borstlab/super_bowl_screen/README.md

# super_bowl_screen

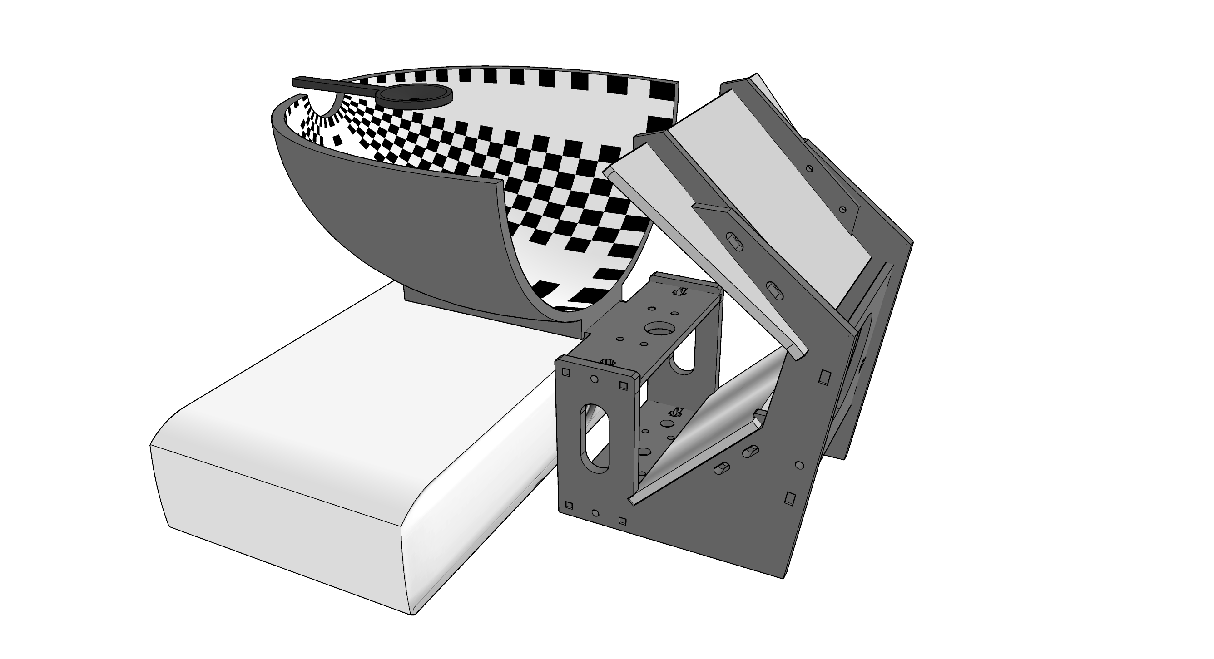
[picture p1: Bowl_Arena side.png]
bowl_arena
