borstlab/super_bowl_screen/CAD/CAD/_.jpg

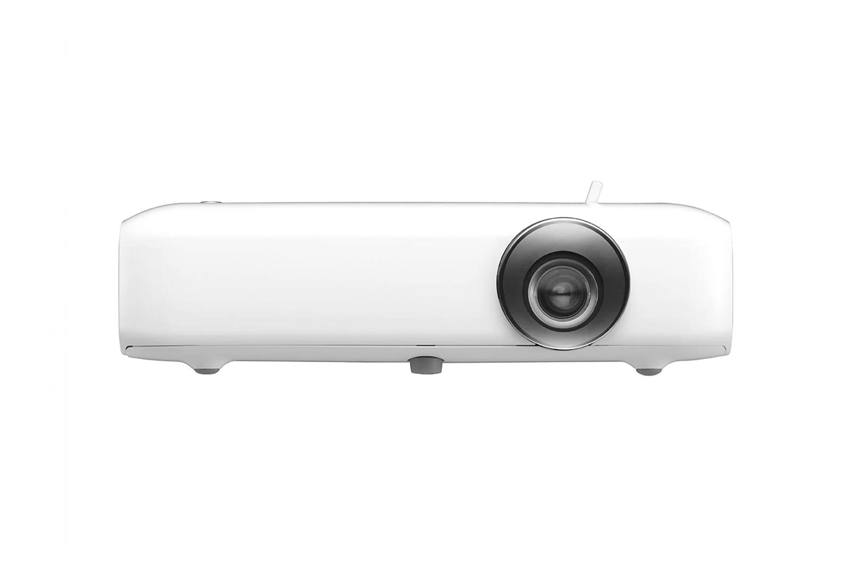
CAD/CAD/_.jpg
