borstlab/super_bowl_screen/CAD/render from inside the bowl.jpg

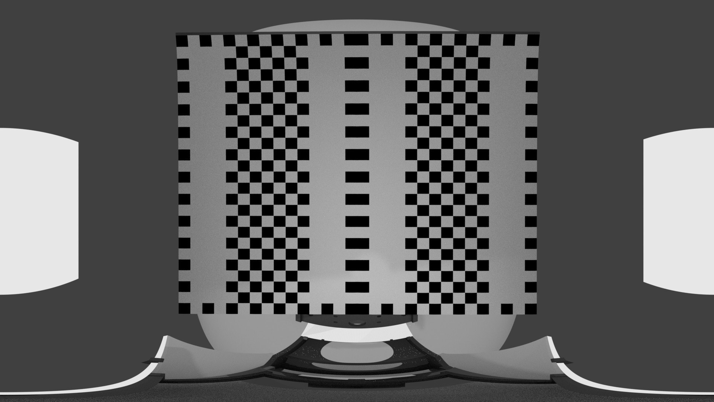
CAD/render from inside the bowl.jpg
