borstlab/super_bowl_screen/Figures/Code/Fig 2/Bleeding13.PNG

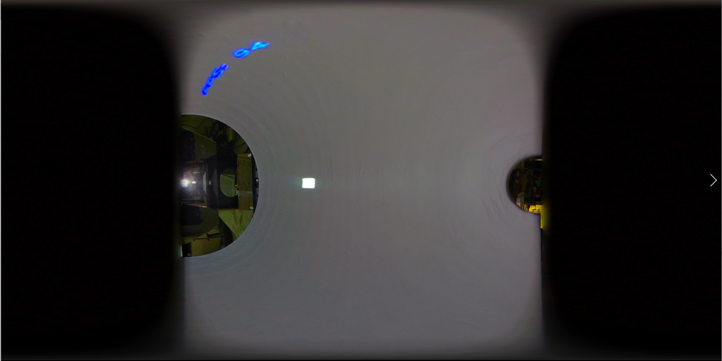
Figures/Code/Fig 2/Bleeding13.PNG
