borstlab/super_bowl_screen/Figures/Code/Fig 2/Bleeding18.PNG

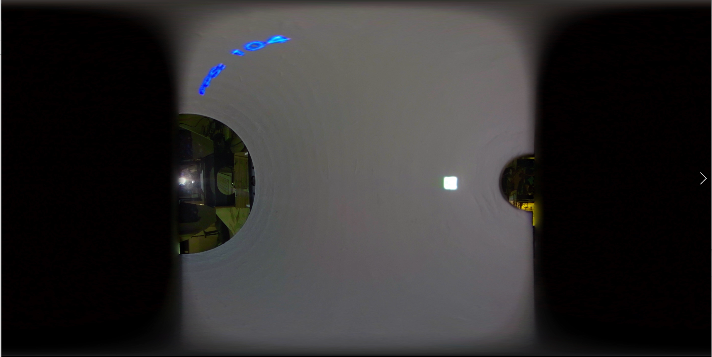
Figures/Code/Fig 2/Bleeding18.PNG
