borstlab/super_bowl_screen/CAD/3d Print V1.1/Bowl_LG_VS2_bowl_holder.stl

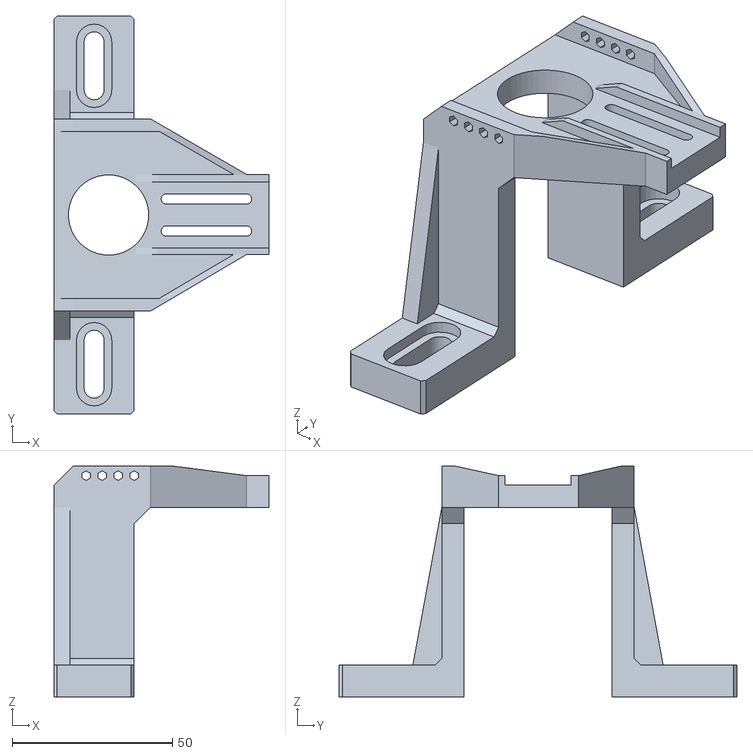
[picture p7: CAD file, 2024-04-22]
CAD/3d Print V1.1/Bowl_LG_VS2_bowl_holder.stl
67.0 x 124.0 x 72.0
