borstlab/super_bowl_screen/CAD/Arena Shape 3D print.stl

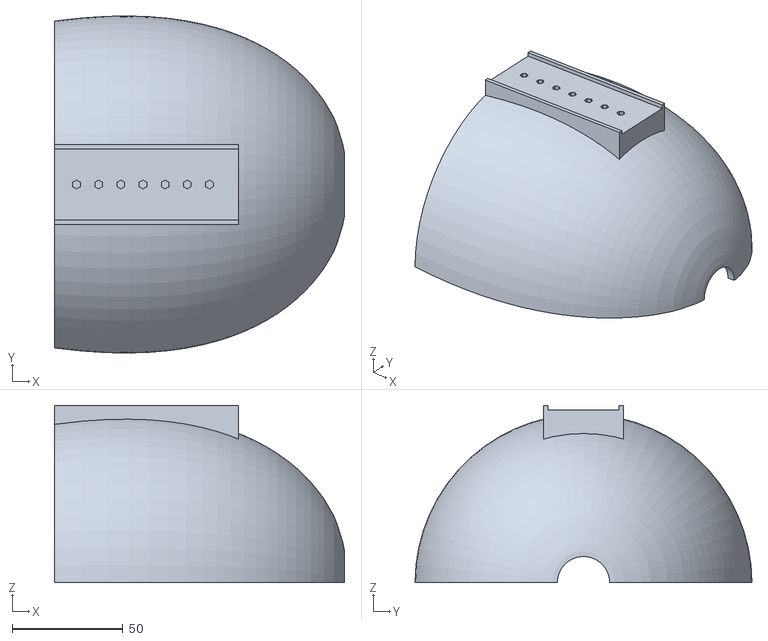
[picture p8: CAD file, 2023-08-11]
CAD/Arena Shape 3D print.stl
131.0 x 152.1 x 80.0
