borstlab/super_bowl_screen/CAD/CAD/Bowl_Arena.stl

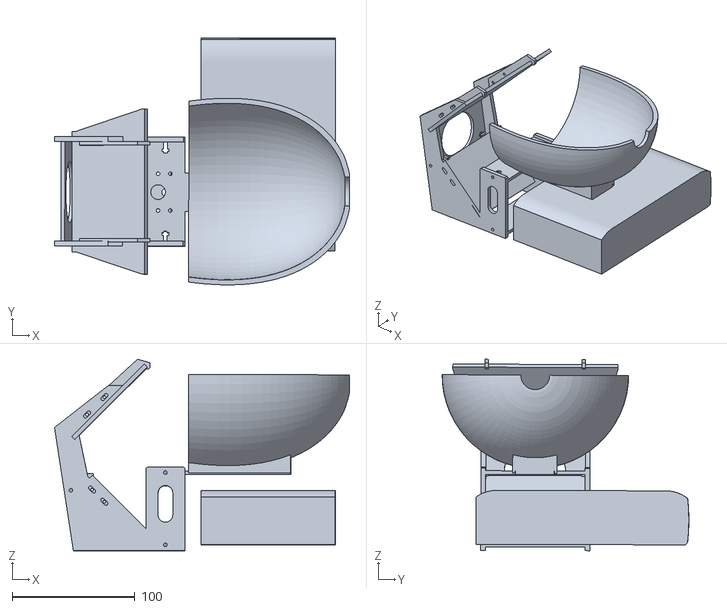
[picture p9: CAD file, 2023-08-11]
CAD/CAD/Bowl_Arena.stl
240.5 x 201.2 x 156.1
