borstlab/super_bowl_screen/(list of files, cad)

Other CAD files:
CAD/CAD/Bowl_Arena.obj
CAD/CAD/Bowl_arena.skp
CAD/CAD/bowl arena.blend
