borstlab/super_bowl_screen/CAD/3d Print V1.1/Bowl_LG_VS2 disassembled.png

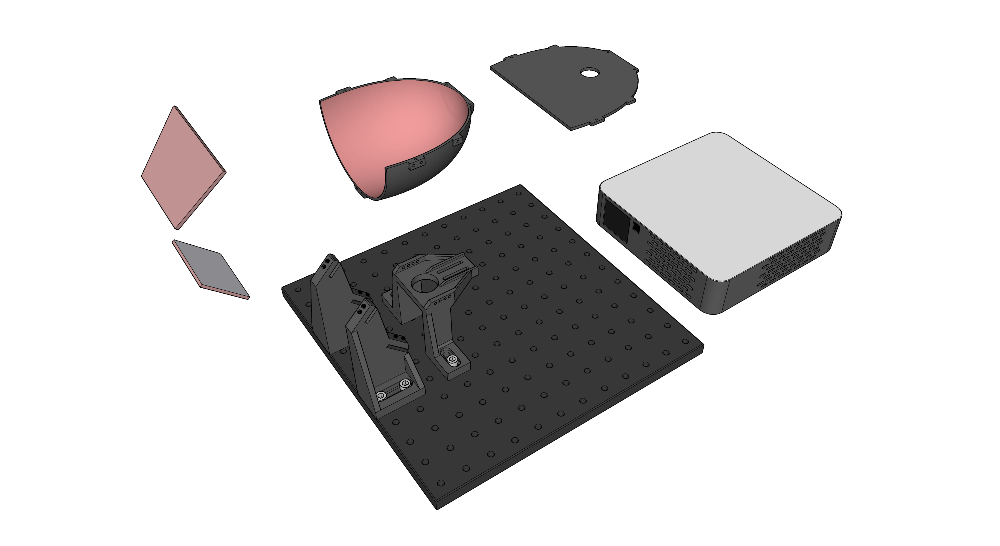
CAD/3d Print V1.1/Bowl_LG_VS2 disassembled.png
